DJRGVC/Vortex-Generators/CFD/cfd_drag_comprehensive_comparison.png

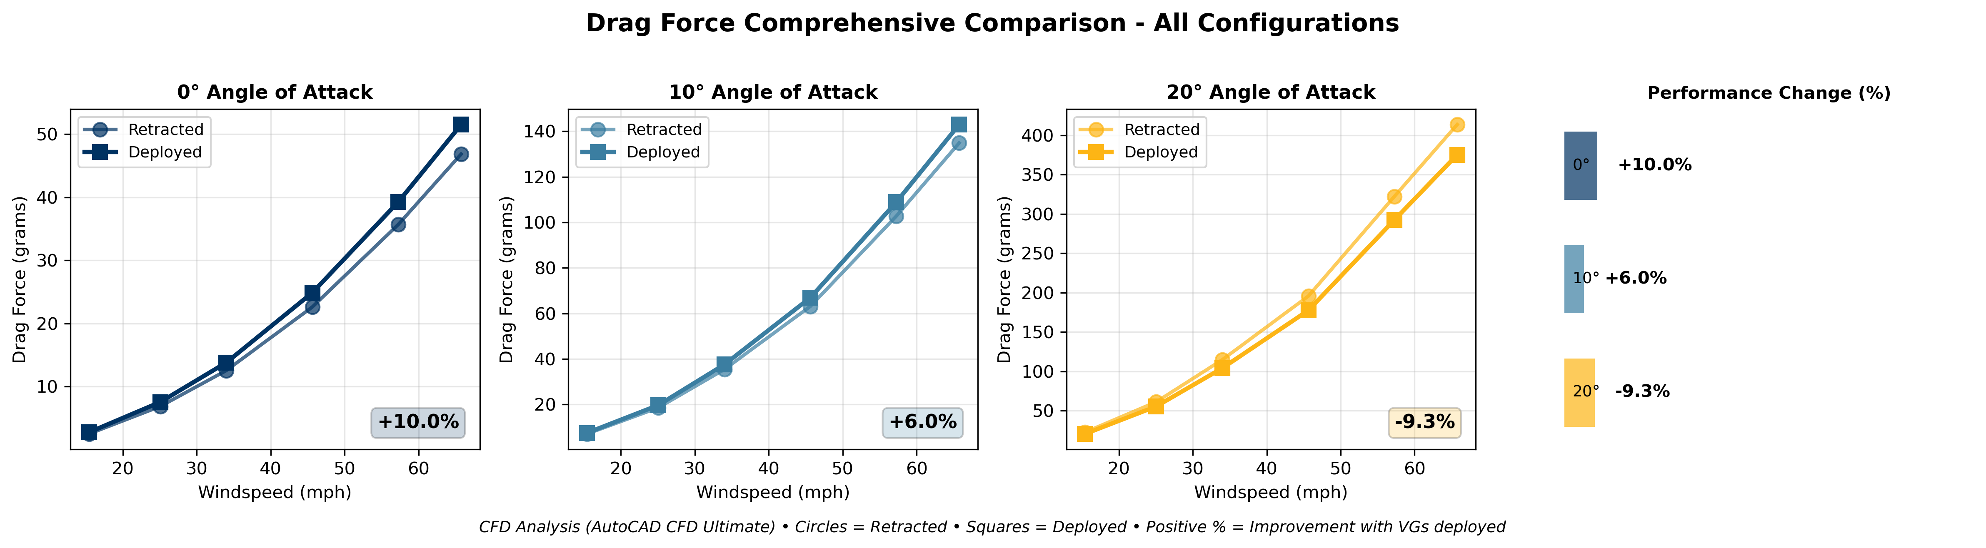
CFD/cfd_drag_comprehensive_comparison.png
