DJRGVC/Vortex-Generators/CFD/cfd_drag_extended_all_data.png

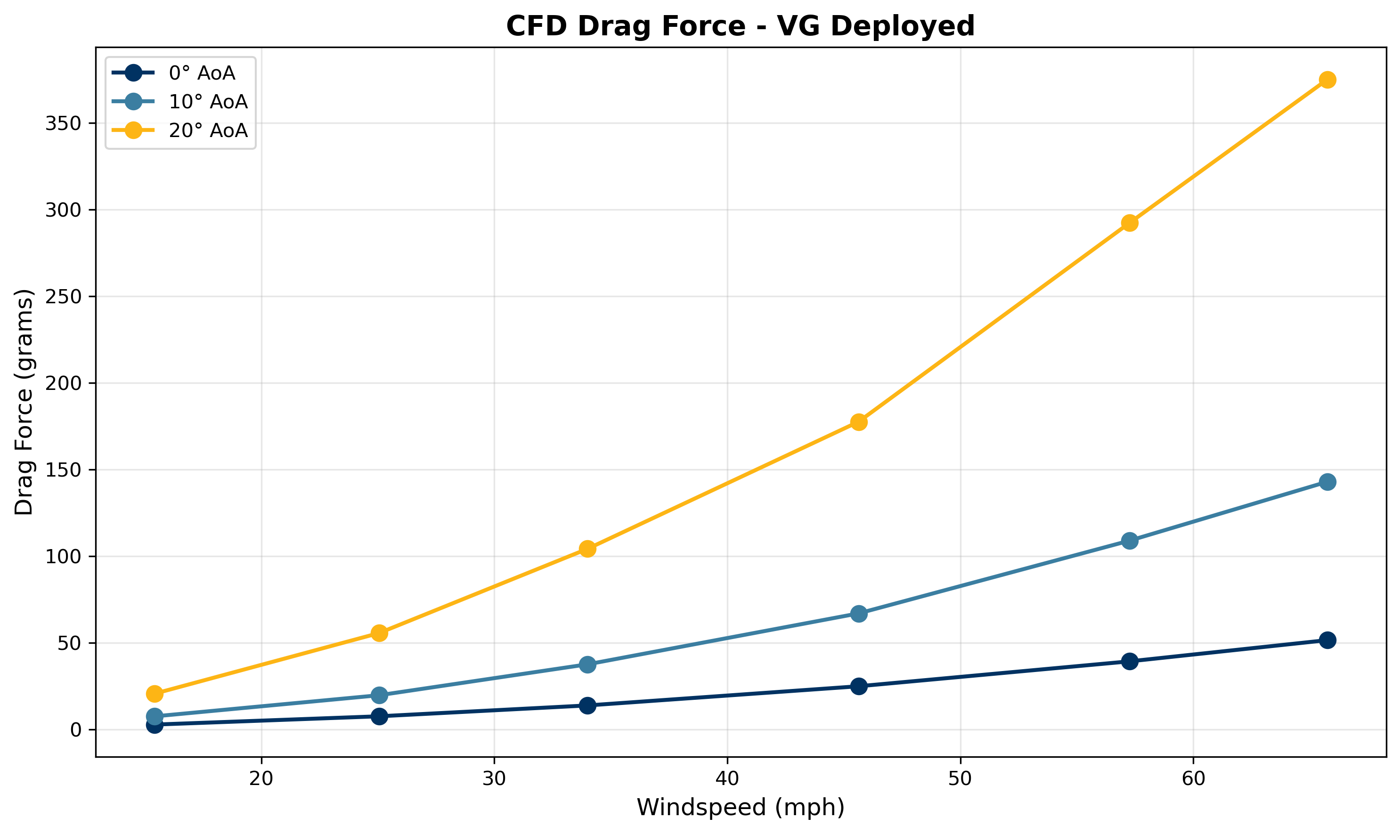
CFD/cfd_drag_extended_all_data.png
