DJRGVC/Vortex-Generators/CFD/cfd_drag_retracted_all_data.png

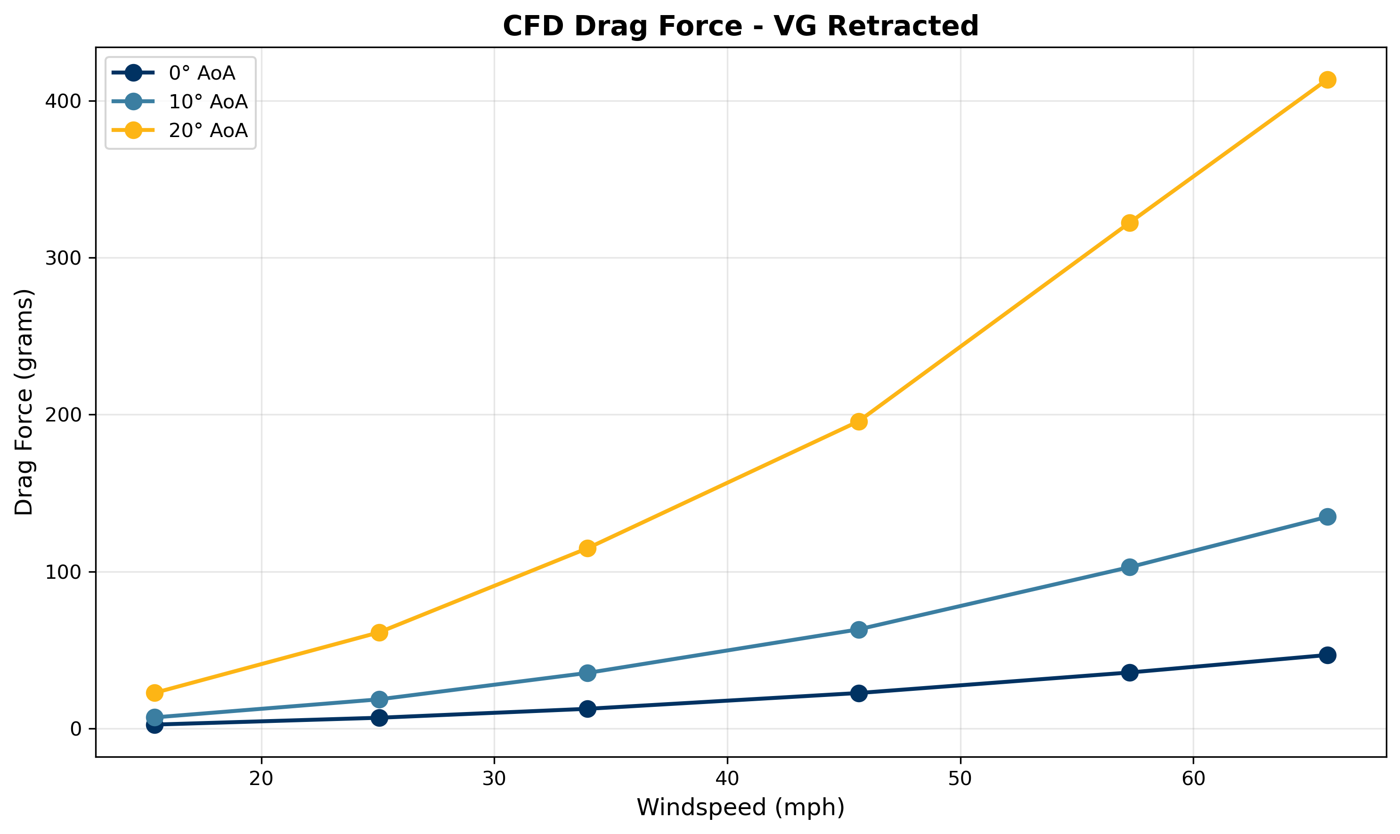
CFD/cfd_drag_retracted_all_data.png
