DJRGVC/Vortex-Generators/CFD/cfd_lift_comprehensive_comparison.png

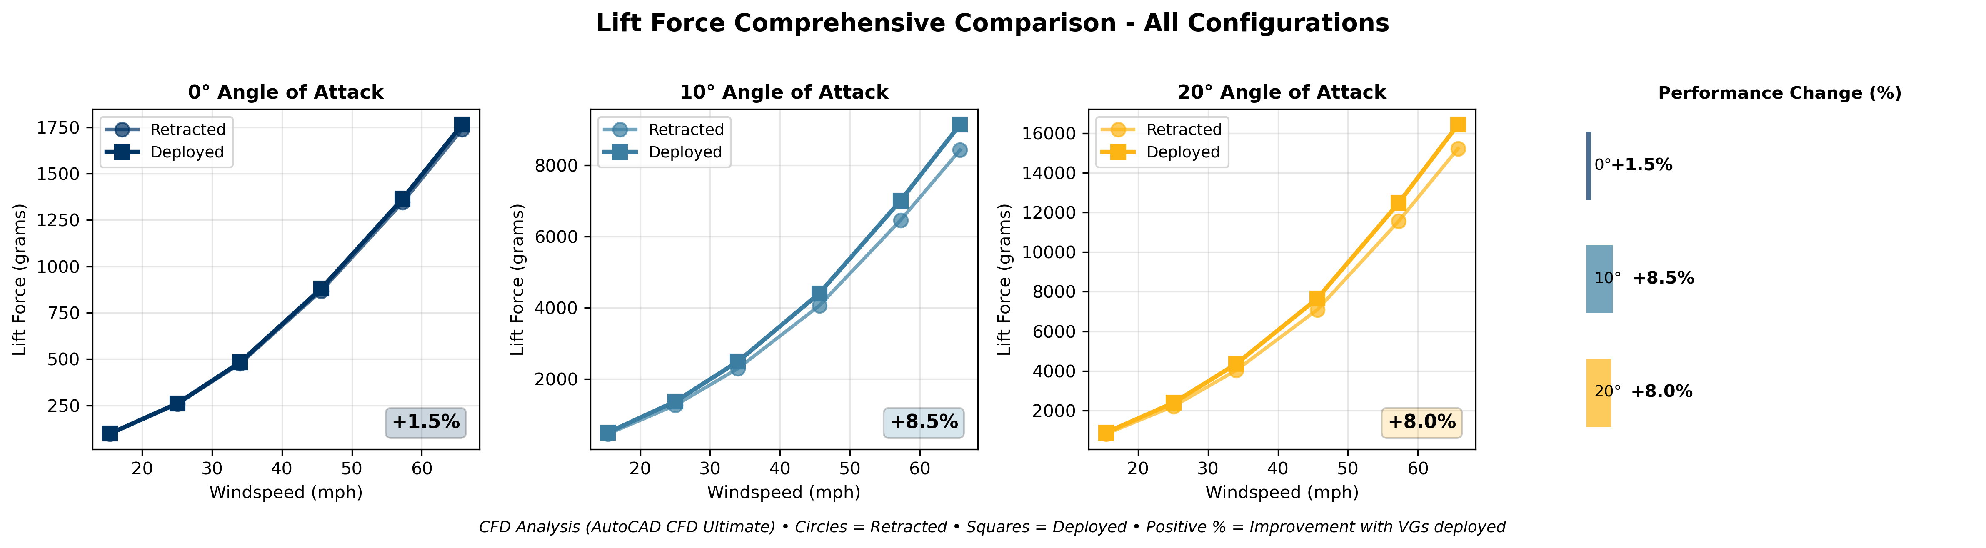
CFD/cfd_lift_comprehensive_comparison.png
