DJRGVC/Vortex-Generators/CFD/cfd_lift_extended_all_data.png

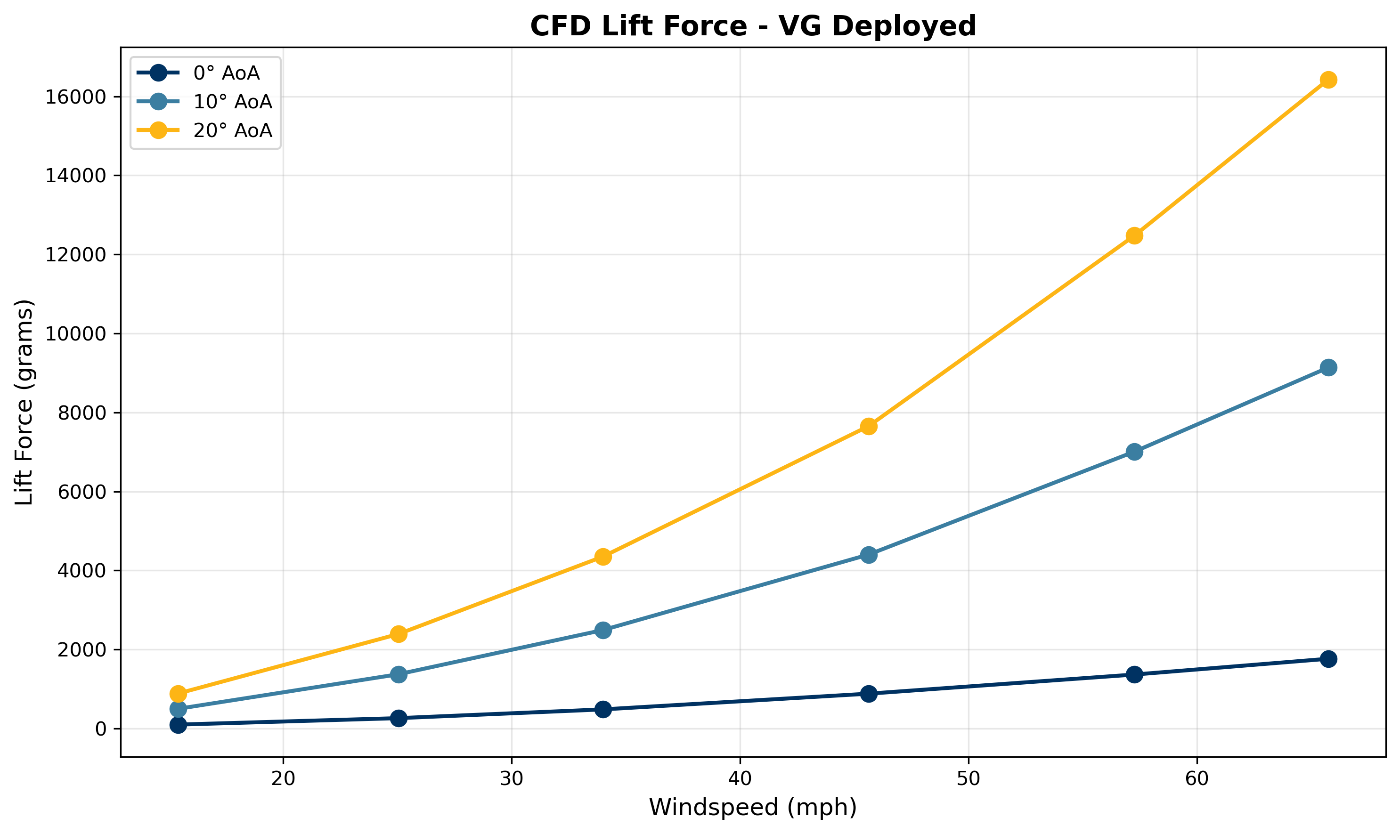
CFD/cfd_lift_extended_all_data.png
