DJRGVC/Vortex-Generators/Windtunnel_testing/0deg_run4.xls

LabVIEW Measurement
Writer_Version | 2
Reader_Version | 2
Separator | Tab
Decimal_Separator | .
Multi_Headings | No
X_Columns | One
Time_Pref | Absolute
Operator | ME
Date | 2025/12/11
Time | 16:19:42.0794057846069335938
***End_of_Header***
Channels | 6
Samples | 1 | 1 | 1 | 1 | 1 | 1
Date | 2025/12/11 | 2025/12/11 | 2025/12/11 | 2025/12/11 | 2025/12/11 | 2025/12/11
Time | 16:59:25.6704049110412597656 | 16:59:25.6704049110412597656 | 16:59:25.6704049110412597656 | 16:59:25.6624054908752441406 | 16:59:25.6624054908752441406 | 16:59:25.6704049110412597656
X_Dimension | Time | Time | Time | Time | Time | Time
X0 | 0.0000000000000000E+0 | 0.0000000000000000E+0 | 0.0000000000000000E+0 | 0.0000000000000000E+0 | 0.0000000000000000E+0 | 0.0000000000000000E+0
Delta_X | 1.000000 | 1.000000 | 1.000000 | 1.000000 | 1.000000 | 1.000000
***End_of_Header***
X_Value | Untitled | Untitled 1 | Untitled 2 | Untitled 3 | Untitled 4 | Untitled 5 | Comment
0.000000 | 1602.929945 | 1.010429 | 0.003441 | -2.363719 | 0.004680 | 0.740592 | , Columns A-M:, Time, Fan Speed [RPM], PTX1 Cont. Cone [V], PT STD Dev, Strain Gage [V], Strain gage STD Dev, Pitot Tube OS PTX2 (mmHg), Comments
