DJRGVC/Vortex-Generators/Windtunnel_testing/wind tunnel data/deployed_10deg/deployed_10_01.xls

LabVIEW Measurement
Writer_Version | 2
Reader_Version | 2
Separator | Tab
Decimal_Separator | .
Multi_Headings | No
X_Columns | One
Time_Pref | Absolute
Operator | ME
Date | 2025/12/12
Time | 14:16:27.4228038787841796875
***End_of_Header***
Channels | 6
Samples | 1 | 1 | 1 | 1 | 1 | 1
Date | 2025/12/12 | 2025/12/12 | 2025/12/12 | 2025/12/12 | 2025/12/12 | 2025/12/12
Time | 14:29:53.0198040008544921875 | 14:29:53.0198040008544921875 | 14:29:53.0198040008544921875 | 14:29:53.0178046226501464844 | 14:29:53.0178046226501464844 | 14:29:53.0198040008544921875
X_Dimension | Time | Time | Time | Time | Time | Time
X0 | 0.0000000000000000E+0 | 0.0000000000000000E+0 | 0.0000000000000000E+0 | 0.0000000000000000E+0 | 0.0000000000000000E+0 | 0.0000000000000000E+0
Delta_X | 1.000000 | 1.000000 | 1.000000 | 1.000000 | 1.000000 | 1.000000
***End_of_Header***
X_Value | Untitled | Untitled 1 | Untitled 2 | Untitled 3 | Untitled 4 | Untitled 5 | Comment
0.000000 | 797.307570 | 1.101077 | 0.003352 | -2.301932 | 0.002556 | 0.165116 | , Columns A-M:, Time, Fan Speed [RPM], PTX1 Cont. Cone [V], PT STD Dev, Strain Gage [V], Strain gage STD Dev, Pitot Tube OS PTX2 (mmHg), Comments
