DJRGVC/Vortex-Generators/Windtunnel_testing/wind tunnel data/deployed_10deg/deployed_10_03.xls

LabVIEW Measurement
Writer_Version | 2
Reader_Version | 2
Separator | Tab
Decimal_Separator | .
Multi_Headings | No
X_Columns | One
Time_Pref | Absolute
Operator | ME
Date | 2025/12/12
Time | 14:16:27.4228038787841796875
***End_of_Header***
Channels | 6
Samples | 1 | 1 | 1 | 1 | 1 | 1
Date | 2025/12/12 | 2025/12/12 | 2025/12/12 | 2025/12/12 | 2025/12/12 | 2025/12/12
Time | 14:31:43.4208040237426757813 | 14:31:43.4208040237426757813 | 14:31:43.4208040237426757813 | 14:31:43.4168038368225097656 | 14:31:43.4168038368225097656 | 14:31:43.4208040237426757813
X_Dimension | Time | Time | Time | Time | Time | Time
X0 | 0.0000000000000000E+0 | 0.0000000000000000E+0 | 0.0000000000000000E+0 | 0.0000000000000000E+0 | 0.0000000000000000E+0 | 0.0000000000000000E+0
Delta_X | 1.000000 | 1.000000 | 1.000000 | 1.000000 | 1.000000 | 1.000000
***End_of_Header***
X_Value | Untitled | Untitled 1 | Untitled 2 | Untitled 3 | Untitled 4 | Untitled 5 | Comment
0.000000 | 1603.498856 | 1.427742 | 0.011307 | -1.376592 | 0.007906 | 0.771756 | , Columns A-M:, Time, Fan Speed [RPM], PTX1 Cont. Cone [V], PT STD Dev, Strain Gage [V], Strain gage STD Dev, Pitot Tube OS PTX2 (mmHg), Comments
