DJRGVC/Vortex-Generators/Windtunnel_testing/figures/README.md

# Wind Tunnel Analysis Figures

## ⭐ LATEST FINAL GRAPHS ⭐

**📁 Look here first: `LATEST_FINAL_GRAPHS/`**

This folder contains the **6 most recent, final graphs** with:
- ✅ All data points included (including "bad" data)
- ✅ Fixed overlapping text
- ✅ Synthetic (0,0) point added for deployed 20°
- ✅ Improved formatting and spacing
- ✅ Delta analysis bars

### The 6 Final Graphs:

**Individual Plots (4 files):**
1. `lift_retracted_all_data.png` - Lift for retracted VGs at 0°, 10°, 20°
2. `lift_deployed_all_data.png` - Lift for deployed VGs at 0°, 10°, 20°
3. `drag_retracted_all_data.png` - Drag for retracted VGs at 0°, 10°, 20°
4. `drag_deployed_all_data.png` - Drag for deployed VGs at 0°, 10°, 20°

**Comprehensive Comparison Plots (2 files):**
5. `lift_comprehensive_comparison.png` - All 6 configs + delta bars
6. `drag_comprehensive_comparison.png` - All 6 configs + delta bars

---

## Other Folders (For Reference)

### `individual_plots/`
Same as the 4 individual plots in LATEST_FINAL_GRAPHS (duplicates for organization)

### `comprehensive_comparison/`
Same as the 2 comprehensive plots in LATEST_FINAL_GRAPHS (duplicates for organization)

### `original_analysis/`
Earlier versions WITHOUT the "bad" data points - kept for comparison

---

**Generated:** December 18, 2025, 7:30 PM
**Script:** `analyze_all_configurations_final.py`
