DJRGVC/Vortex-Generators/Windtunnel_testing/figures/LATEST_FINAL_GRAPHS/README.txt

⭐⭐⭐ THESE ARE THE LATEST FINAL GRAPHS ⭐⭐⭐

Generated: December 18, 2025 at 7:30 PM
Script: analyze_all_configurations_final.py

THIS FOLDER CONTAINS THE 6 MOST RECENT, FINAL GRAPHS:

✅ All data points included (including "bad" data from deployed 20°)
✅ Fixed overlapping text on comprehensive plots
✅ Synthetic (0,0) point added for deployed 20° baseline
✅ Improved formatting with better spacing
✅ Delta analysis bars showing % improvement

━━━━━━━━━━━━━━━━━━━━━━━━━━━━━━━━━━━━━━━━━━━━━━━━━━━━

THE 6 FILES:

Individual Plots (4 files):
1. lift_retracted_all_data.png
2. lift_deployed_all_data.png
3. drag_retracted_all_data.png
4. drag_deployed_all_data.png

Comprehensive Comparison Plots (2 files):
5. lift_comprehensive_comparison.png - Shows all 6 configs + delta bars
6. drag_comprehensive_comparison.png - Shows all 6 configs + delta bars

━━━━━━━━━━━━━━━━━━━━━━━━━━━━━━━━━━━━━━━━━━━━━━━━━━━━

USE THESE FOR YOUR REPORT/PRESENTATION!
