DJRGVC/Vortex-Generators/Windtunnel_testing/calibration_curve.png

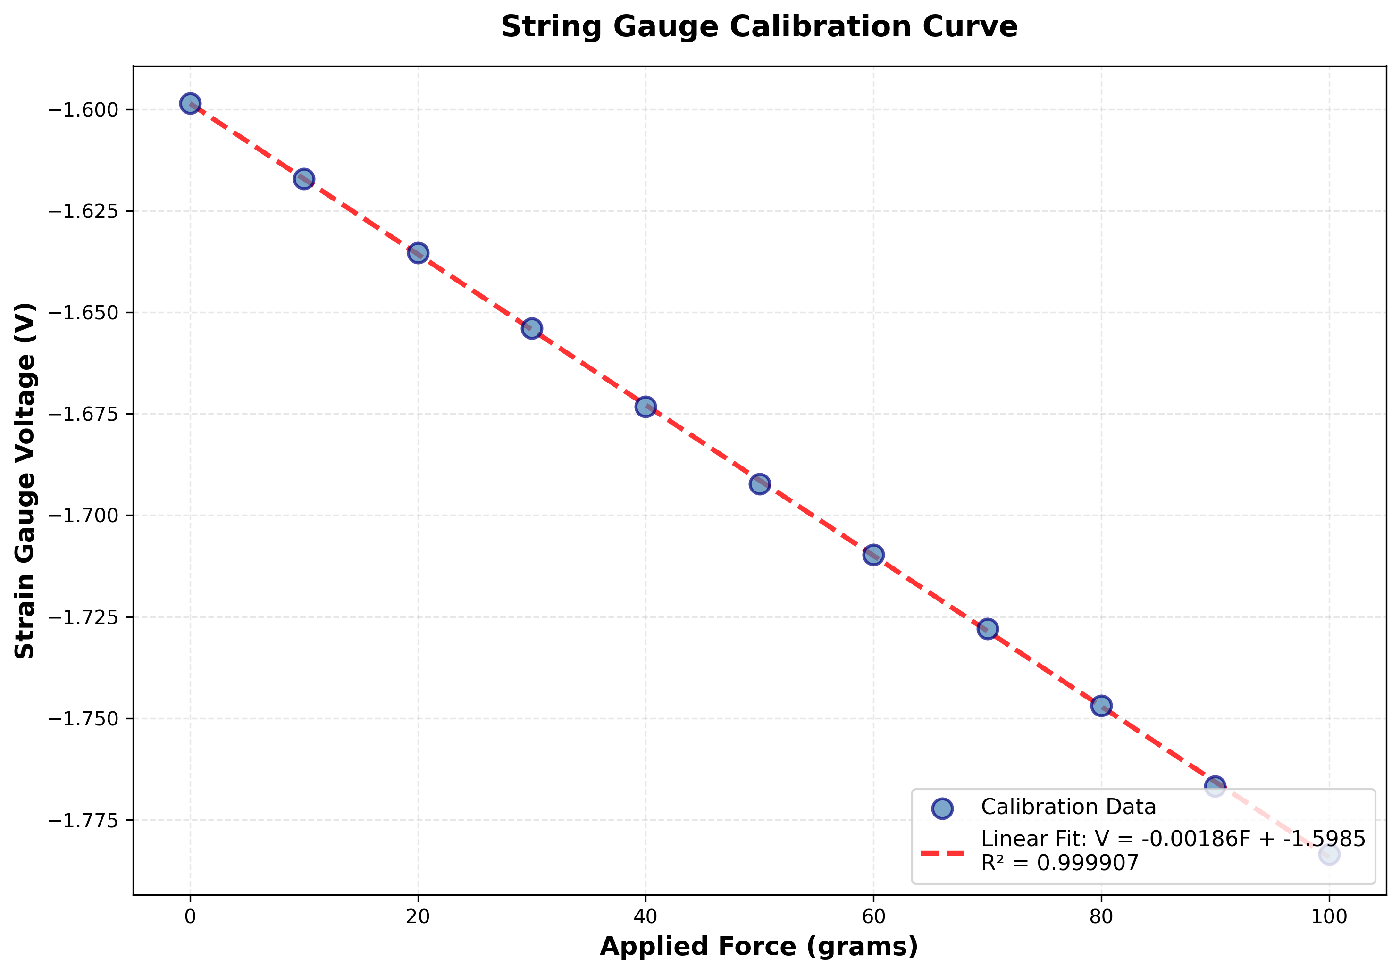
Windtunnel_testing/calibration_curve.png
