DJRGVC/Vortex-Generators/Windtunnel_testing/combined_analysis.png

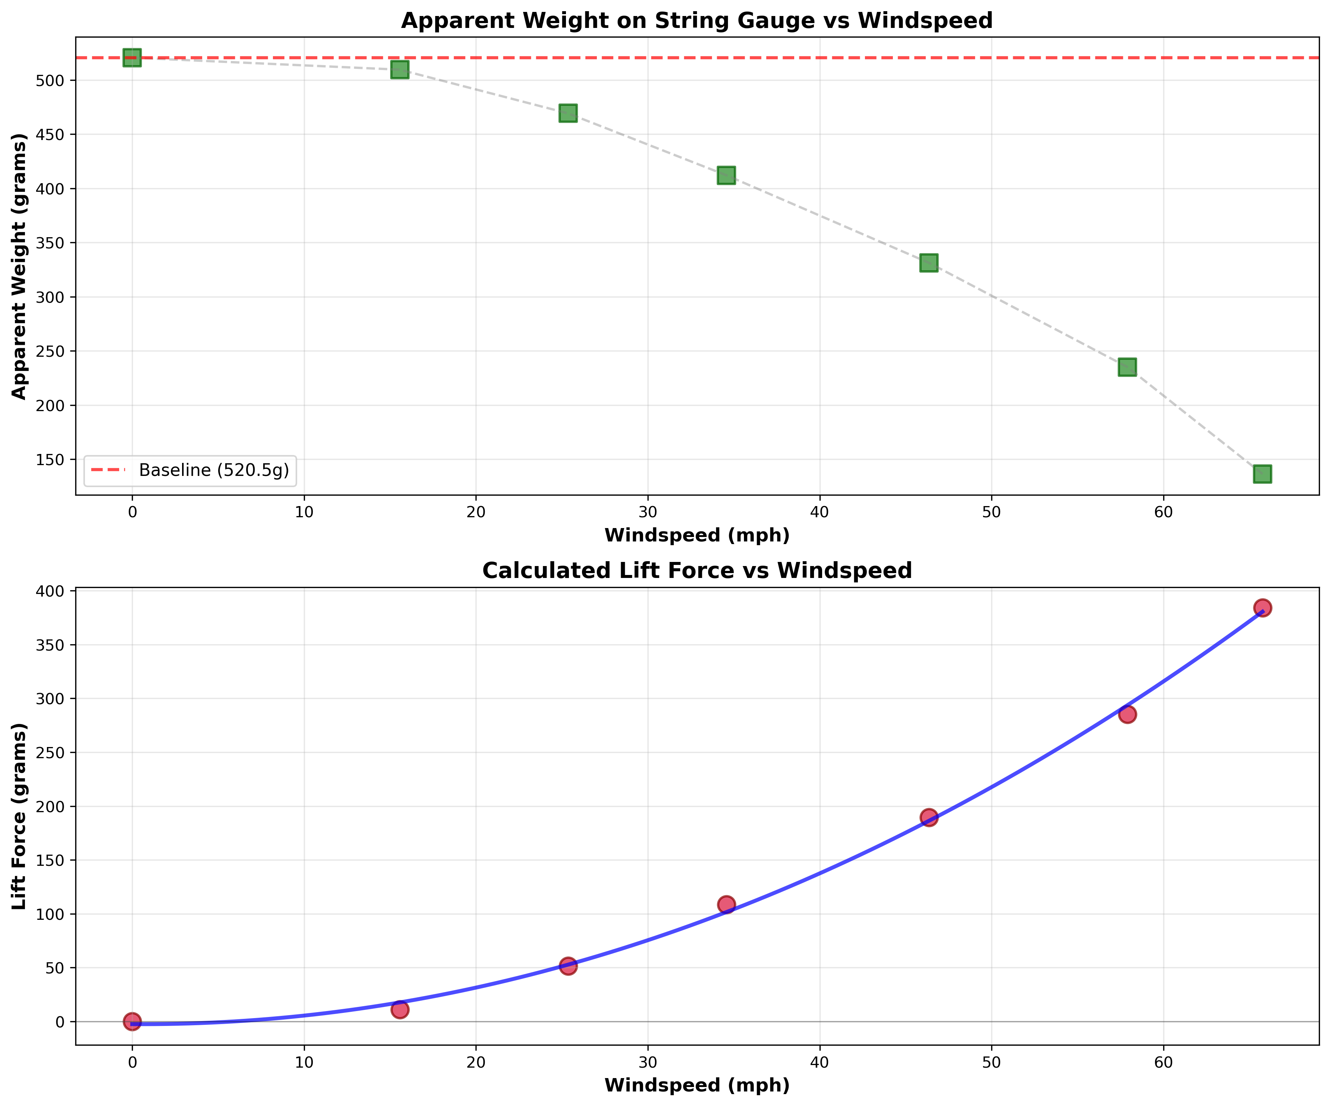
Windtunnel_testing/combined_analysis.png
