DJRGVC/Vortex-Generators/Windtunnel_testing/figures/comprehensive_comparison/drag_comprehensive_comparison.png

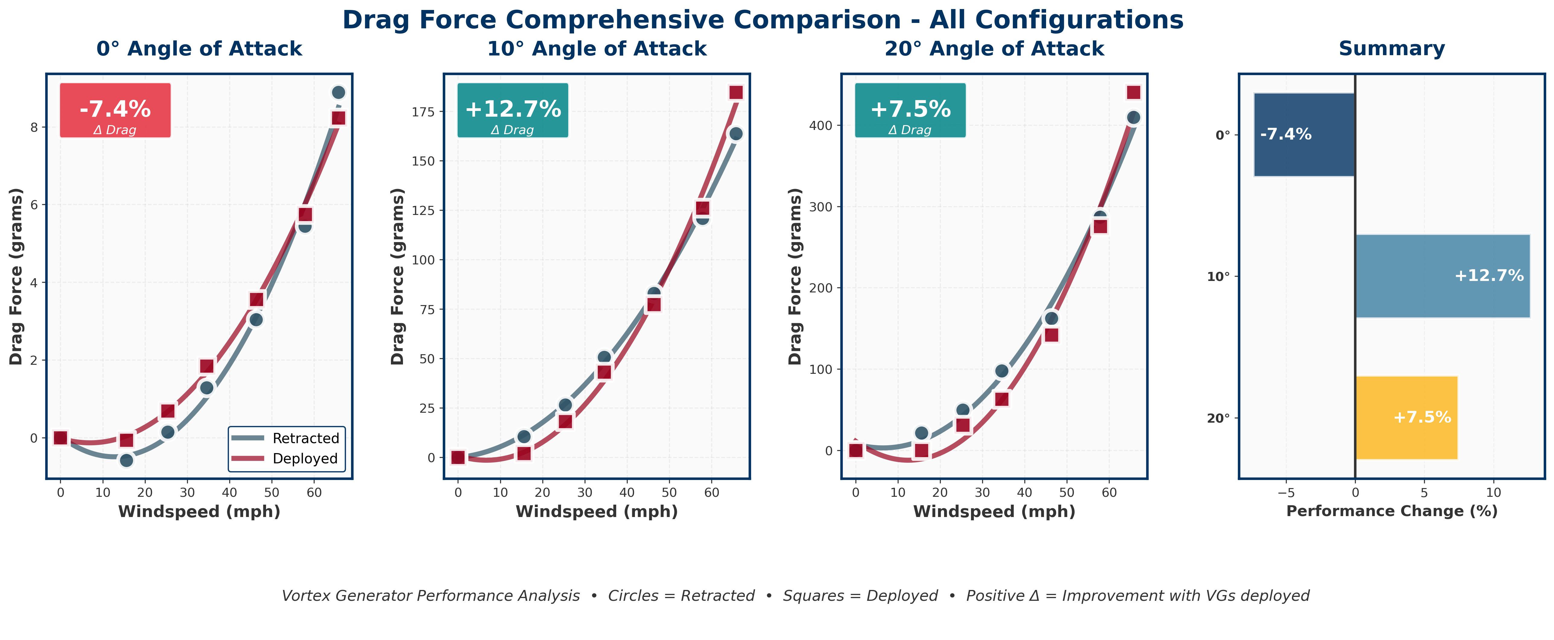
Windtunnel_testing/figures/comprehensive_comparison/drag_comprehensive_comparison.png
