DJRGVC/Vortex-Generators/Windtunnel_testing/figures/individual_plots/drag_retracted_all_data.png

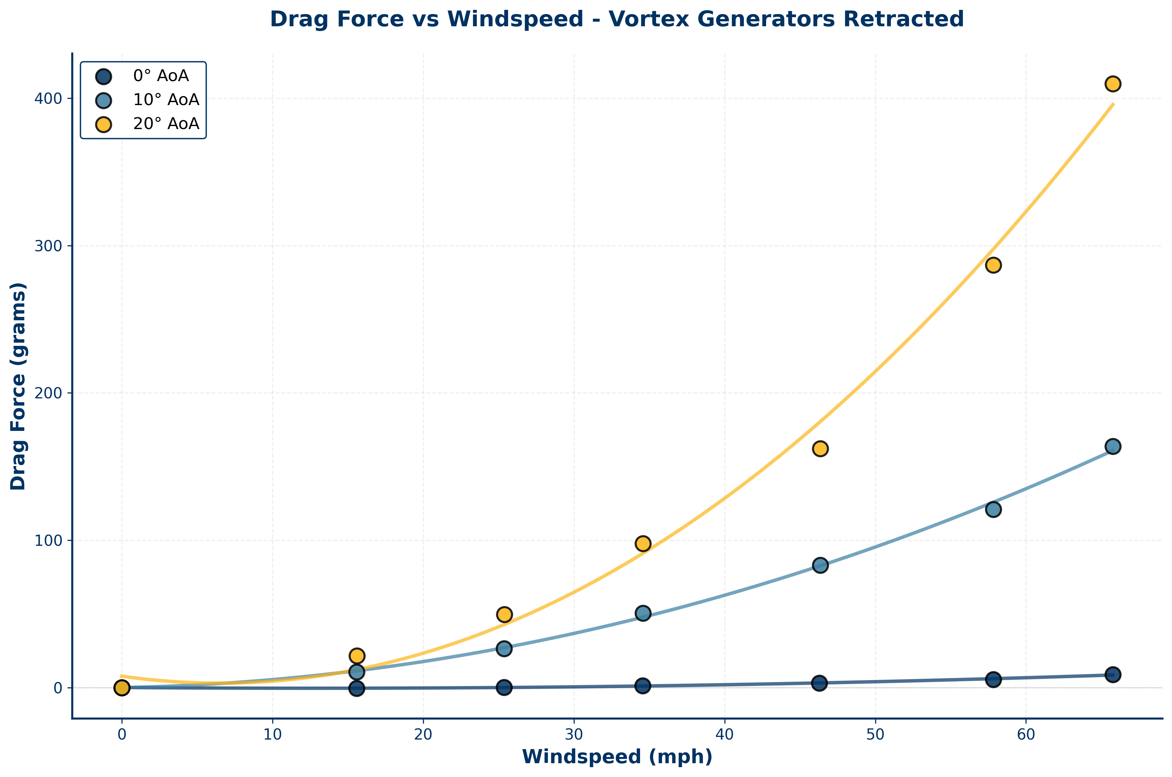
Windtunnel_testing/figures/individual_plots/drag_retracted_all_data.png
