DJRGVC/Vortex-Generators/Windtunnel_testing/figures/individual_plots/lift_deployed_all_data.png

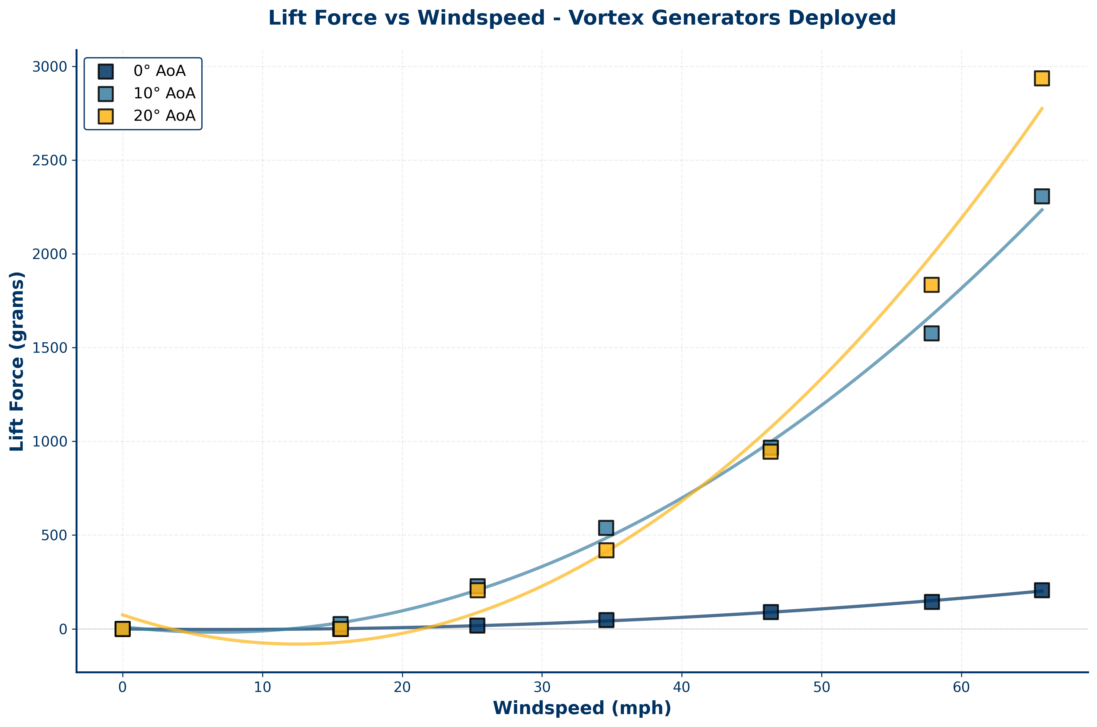
Windtunnel_testing/figures/individual_plots/lift_deployed_all_data.png
