DJRGVC/Vortex-Generators/Windtunnel_testing/figures/original_analysis/lift_deployed_all_angles.png

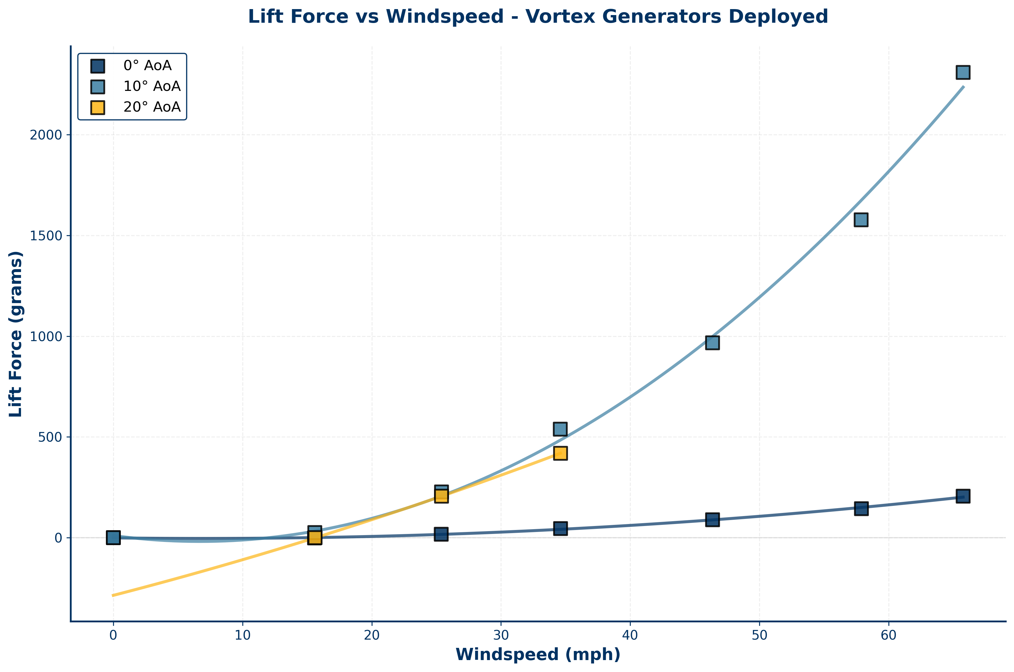
Windtunnel_testing/figures/original_analysis/lift_deployed_all_angles.png
