DJRGVC/Vortex-Generators/Windtunnel_testing/force_vs_windspeed_detailed.png

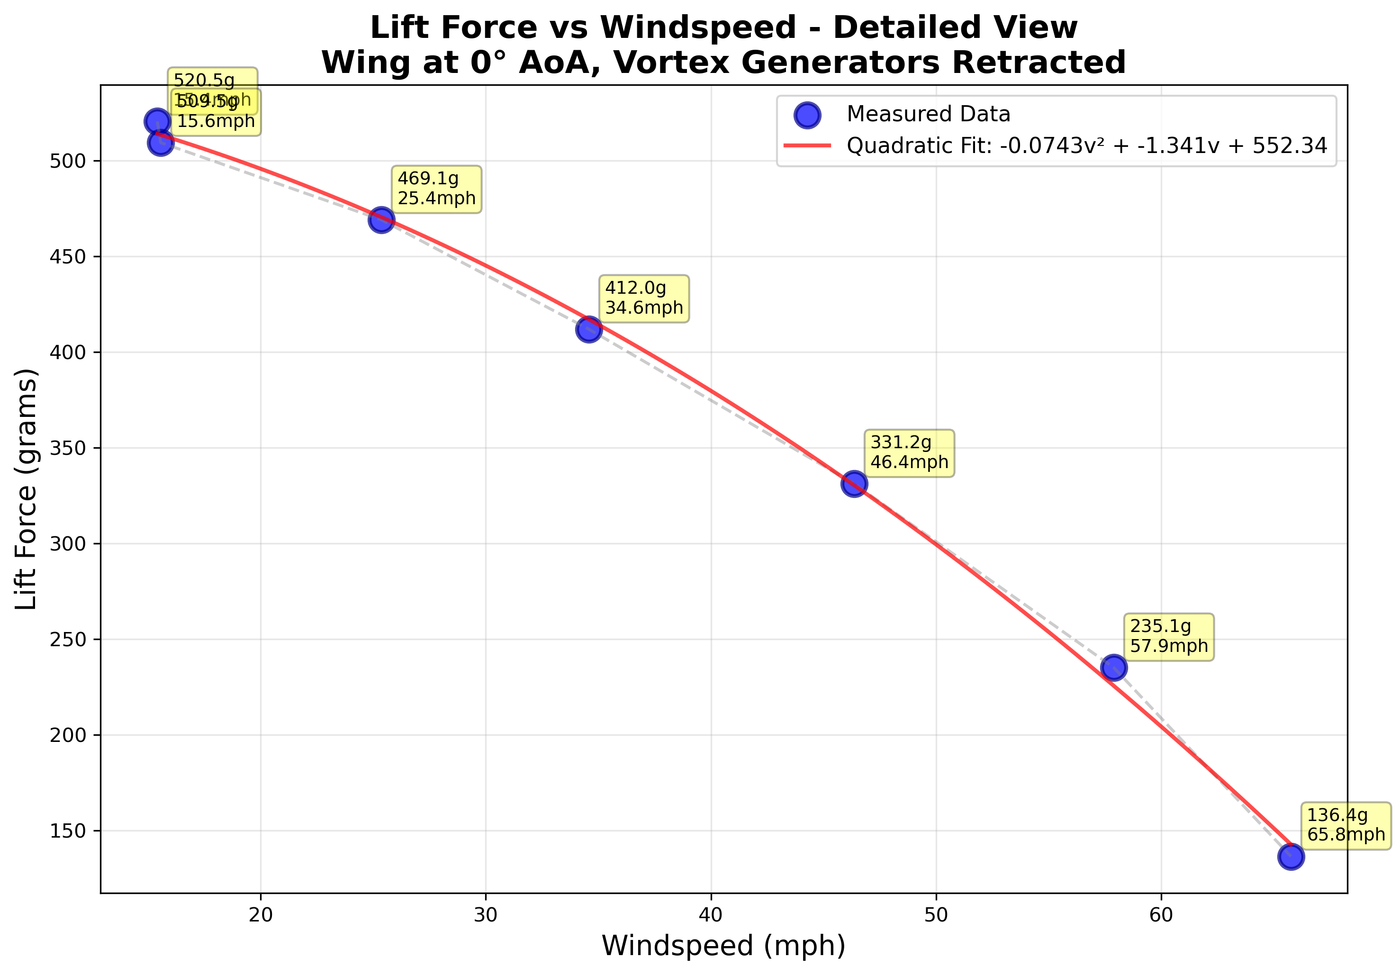
Windtunnel_testing/force_vs_windspeed_detailed.png
