DJRGVC/Vortex-Generators/Windtunnel_testing/lift_vs_windspeed.png

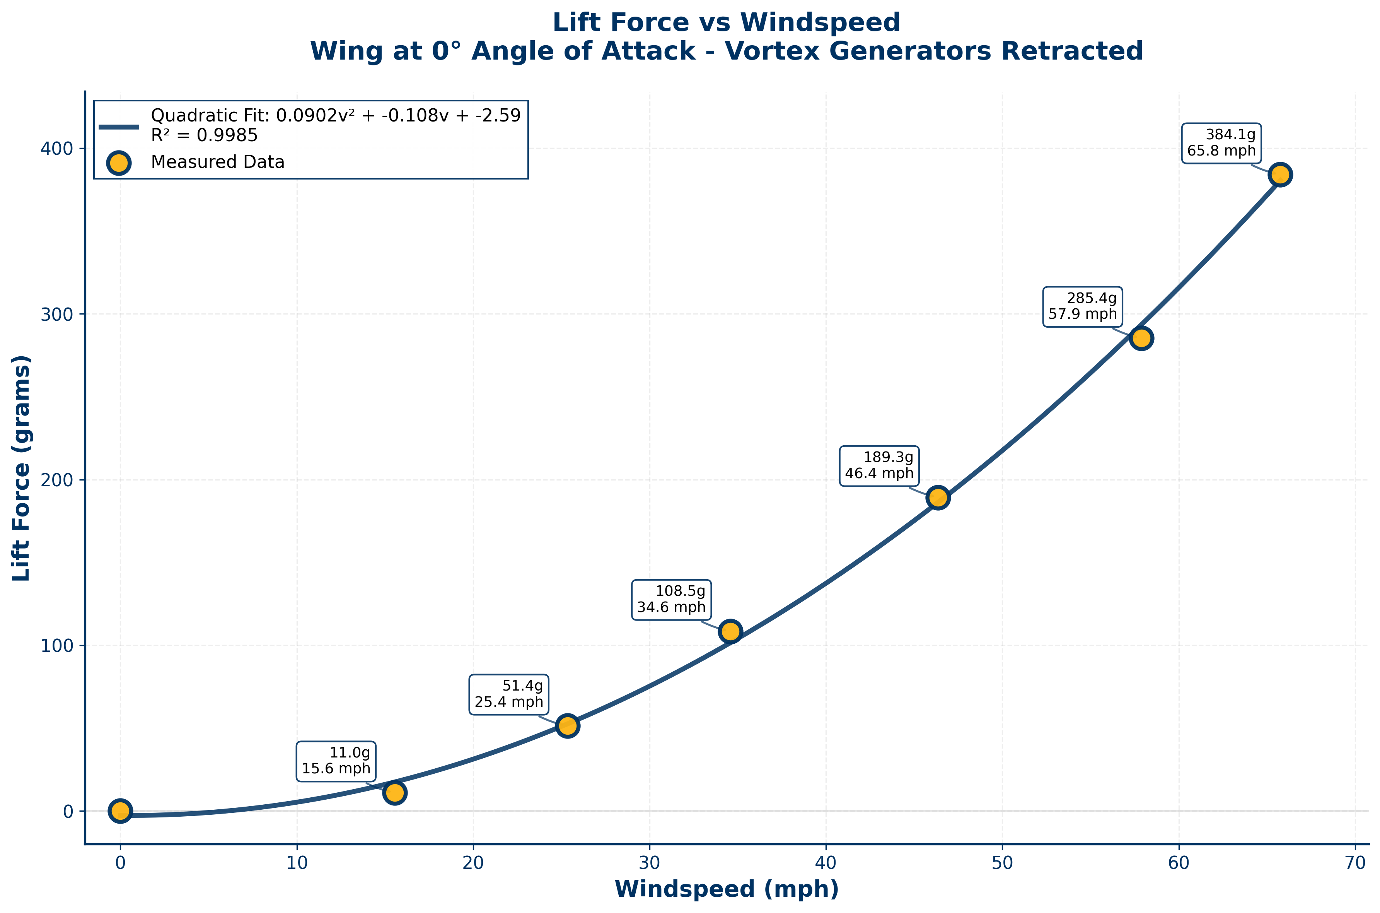
Windtunnel_testing/lift_vs_windspeed.png
