DJRGVC/Vortex-Generators/Windtunnel_testing/windtunnel_analysis.png

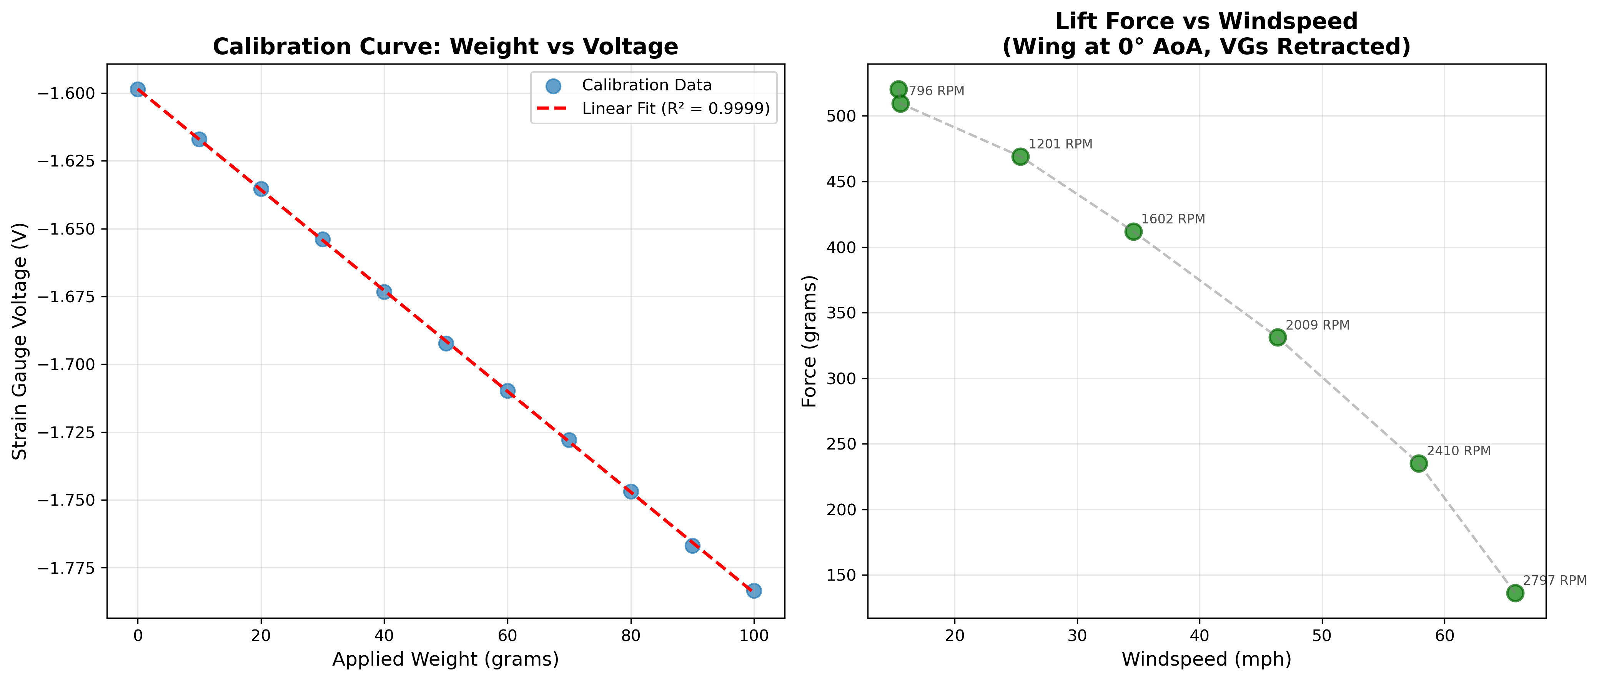
Windtunnel_testing/windtunnel_analysis.png
