DJRGVC/Vortex-Generators/(commit log)

2025-11-24 Initial Commit w/ sensor control code + tests
2025-12-01 Motor controlling prelim
2025-12-01 added calibration, auto run, etc
2025-12-01 minor changes to sensor control mechanism
2025-12-07 pitch sign flip in auto_control, added adjusted 50/50 methoid to readme.
    [auto_control.ino]
2025-12-19 figures added
    [0deg_run1.xls, 0deg_run2.xls, 0deg_run3.xls, 0deg_run4.xls, 0deg_run5.xls, 0deg_run6.xls, 0deg_run7.xls, calibration0g.xls]
2025-12-20 CFD results, additional graphical data.
    [cfd_results_complete.csv, top_surface_VG_extended_100mph_0aoa_from_autocad_cfd_ultimmate.csv]
